Torxgewinde/Firebeetle-2-ESP32-E/(threads)

Thread 1 (2021-09-09):

VS Code Plattform.io IDE usage

progl0r, 2021-09-09:
Hey Torxgewinde,

thanks for the nicely done coding, very interesting application. My question is actually not related to the code itself. I guess you compiled and build the binaries with the Arduino IDE? Im working with VS code and platform.io but since I only find the Firebeetle (based on the ESP32, not E) board I wonder, if I could use the "old" board definition to flash your code. Do you have any information about that?

Best
Progl0r

Torxgewinde, 2021-09-10:
Hello ProgL0r,
Thank you. Yes, the *.ino files can be compiled with Arduino and PlatformIO. Also your guess is correct: I just used the predecessor Firebeetle ESP32 as board. Just a short while ago (=10 days as of now) the [Arduino ESP32 released a new version](https://github.com/espressif/arduino-esp32/releases/tag/2.0.0) and I did not check yet if the Firebeetle 2 ESP32-E is now included. Practically, the difference between previous Firebeetle ESP32 (SKU:DFR0478) and ESP32-E (SKU:DFR0654) did not matter, because I looked up the GPIO / Pin definitions from the DFRobot [schematic](https://dfimg.dfrobot.com/nobody/wiki/fd28d987619c16281bdc4f40990e5a1c.PDF) and [Wiki](https://wiki.dfrobot.com/FireBeetle_Board_ESP32_E_SKU_DFR0654) and did not use the Pin numbers like D\<number\>. The binaries the compiler is generating for ESP32 seem to run on ESP32-E unchanged. Obviously, I recommend to use the correct target once it is selectable to avoid obscure issues as it still might be a little bit different. If you are curious, the DFRobot specific changes are available [here](http://download.dfrobot.top/FireBeetle/). You can download the *.zip file and see that there is a file ```0.2.1/variants/esp32-e/pins_arduino.h``` that is just a pin mapping that can be avoided if you just use the GPIO numbers according to the pinout provided by DFRobot. The ```02.1./boards.txt``` contains the compile options for both variants, but without using things like PSRAM etc. it does also not cause practical issues just selecting the "old" ESP32 based Firebeetle.

TL;DR: For this project selecting the Firebeetle ESP32 works. If ESP32-E is available use that.

Thread 2 (2021-09-10):

Swap in Panasonic PaPIR

Torxgewinde, 2021-09-10:
1. HC-SR501 draws more current than the Panasonic PaPIRs. Swap in PaPIR and collect information about discharge rate, number of transmissions and wakeups.
2. Power PIR sensor through GPIO pin and switch the GPIO to LOW if battery is critically low and back to HIGH if battery is charged again.

Torxgewinde, 2021-11-23:
Done today, logging and patience will show by how much it improves

Closed 2021-11-23.

Thread 3 (2022-11-04):

Firebeetle (1) Version 4

Stefan774, 2022-11-04:
Hi I tried your code with my Firebeetle esp32 board but it does not work.
I noticed that you used the Firebeetle 2. Is it possible to add support vor Firebeetle (v1) as well? Or is HW missing?

Here is the board I'm using https://eckstein-shop.de/DFRobotFireBeetleESP32IOTMicrocontrollerSupportsWi-Fi26amp3BBluetoothEN

 Thanks in advance

Torxgewinde, 2022-11-04:
Hello Stefan,
The sketch in its current state is quite specific to the Firebeetle-2, but in general it should be doable to adjust it to also work with the predecessor. Certainly the GPIOs and internal peripheral names need to be checked and adjusted.

There is a schematic for Firebeetle v1 at https://raw.githubusercontent.com/DFRobot/Wiki/master/DFR0478/%5BDFR0478%5DFireBeetle%20Board-ESP32(V4.0)%E7%94%9F%E4%BA%A7%E6%A3%80%E6%9F%A5%E5%9B%BE.PDF

If you write "does not work", can you be more precise? Does it generate no output at all or can you paste the serial output after powering the Firebeetle v1 up? Can you please post the output of the serial console?

Torxgewinde, 2022-11-21:
Hey Stefan,
I am closing this for being stale. Please let me know if this is to be reopened.

Stefan774, 2022-11-21:
Hi Sorry had no time to reproduce the output and past it here. It showed an static value which seems not to represent the bat voltage. I think the v1 is missing the built in voltage defider. So add HW is needed? But dont know

Torxgewinde, 2022-11-21:
No worries, all good.
The v1 seems to have the voltage divider as well and it seems to be connected to A0. The schematic actually shows this:
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

If you find the time, can you please paste the output? Perhaps it gives some better insight.

tomkeuper, 2023-02-24:
I also have a Firebeetle ESP32 V4.0 and I wanted to get the battery voltage but using the readBattery function you sent here its giving me a voltage of 0.284000 but it fluctuates quite a bit to 0.754, 0.688 etc quite far from the exptected 3 Volts. I connected the battery through the Li-ion connector and all my script is doing atm is sending some sensor data over MQTT.

Could it be some calculation issue?

Closed 2022-12-24.

Thread 4 (2022-12-19):

REED switch input, reading out gas-meter (was: Connection of pir sensor)

VoyteckPL, 2022-12-19:
Which gpio pins are used to connect pir sensor? Is it possible to use reed sensor instead? I would lile to use this project for gas meter.

Torxgewinde, 2022-12-24:
Hi,
The comments point this out:
```
//PIR motion sensor is connected to GPIO4 (Pin: D12)
#define PIR_GPIO 4
#define PIR_DEEPSLEEP_PIN GPIO_NUM_4
```

In general reading a reed-switch should also be able to trigger the wakeup. Depending on the number of times it wakes the processor, just counting the events and transmitting a few times a day might be required to achieve good runtime. This certainly requires several changes, but is certainly achievable.

VoyteckPL, 2022-12-24:
Thanks. Is there any chance you could help me with the code? I can see you made a pro job here. I'm a total noob when it comes to arduino. I see there are some pir specific option like ignore after motion etc. I would be grateful if you could help.

Torxgewinde, 2022-12-24:
@VoyteckPL : Sure, I am willing to assist, however I am not coding it for you. I am also interested in measuring my gasmeter with a reed switch or the ESP32 internal hall sensor. If you have specific questions I suggest you post code and we can discuss and tweak it until it works. If the result is indeed powersaving enough, that is something I can only imagine but not promise yet. It SHOULD be OK in my opinion.

VoyteckPL, 2022-12-27:
Ok. When Firebeetle arrives I will do some testing. When I look at your code it seems to be good for reed switch with very little adjustments.

Torxgewinde, 2022-12-27:
That's cool. I also ordered a REED switch to test it and am looking forward to collaborate.

VoyteckPL, 2022-12-27:
Nice! My firebeetle should arrive tomorrow 🙂

VoyteckPL, 2022-12-28:
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

I'm trying to compile the code but I get this error. Which exactly libraries did you use?

#include <WiFi.h>
#include <MQTT.h>

#include "esp_adc_cal.h"

Torxgewinde, 2022-12-30:
I also need to check with the current Arduino-IDE.

The working versions are:
- Arduino IDE 1.8.13
- ESP32 Board Definitions Version 2.0.2

Maybe some path have changed and need to be updated. I will also use the current IDE and see what might have changed...

VoyteckPL, 2022-12-30:
Ok I will check and report back

Torxgewinde, 2022-12-30:
It also compiles, uploads and send serial output with:

- Arduino IDE 2.0.3
- ESP32 Boards Definition 2.0.6
- MQTT 2.5.0 (https://github.com/256dpi/arduino-mqtt) by Joël Gähwiler

It should compile and run. I haven't entered my WiFi-credentials yet and a full test.

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

VoyteckPL, 2022-12-30:
Fantastic. Thanks. I will do some testing today.

VoyteckPL, 2022-12-30:
Yay! I was able to compile. The problem was I didn't have 2.0.6 Board Definition installed. I had to manually add this link to preferences :

https://raw.githubusercontent.com/espressif/arduino-esp32/gh-pages/package_esp32_index.json

By default it was only 1.0.6.

VoyteckPL, 2022-12-30:
Ok so I sucessfully uploaded firmware! :) My reed sensor should be between pins GND and D12 (GPIO4) right? I won't be using that 3rd cable for 3.3V as I would for PIR sensor.

Torxgewinde, 2022-12-30:
Yes, if you use D12 you won't have to lookup to other `#define` , which saves you some lookups.

To provide current to the sensor, a Pullup or Pulldown resistor must be actived. The Arduino function `pinMode(PIR_GPIO, INPUT_PULLUP)` can be used. When enabling the internal pullup, you connect the reed-switch to D12 and GND.

VoyteckPL, 2022-12-30:
Thank you!
Unfortunately I have no idea how to adjust your code :( I tried but C++ is too hard for me at the moment as I'm newbie....
I can only help with logic and experience as I tested similar solution with Zigbee, Tasmota and ESPHome and I noticed the things which are really important for this gas meter. I can support you somehow if you take it in account. I would also do some testing and report back.

1. Debounce - I used around 1000 ms in Tasmota. This gave me perfect results without any false "clicks". This is a must. With this when gas meter stops just between on and off magnet it can cause multiple fake "clicks"
2. Internal counter in software - example situation > you do something in HA which needs restart but the gas consumption happends in background. In this case the gas consumption will continue but it won't be counted if the counter is in external software.
3. Adjust internal counter value wirelessly (maybe via MQTT) - sometimes you may want to adjust the counter to sync with real gas meter or for some other reason (testing). This should be doable wirelessly.
4. Report battery - already implemented
5. Wifi quality  signal in percent - really useful if gas meter is far away.
6. Ability to see if sensor is ON or OFF - just for information and for statistics.
7. Device should report always if sensor changes from ON to OFF or from OFF to ON.

I suppose that is all.
What I also noticed > I have only gas heater:
When water is heated (cycle which takes around 20 minutes) the usage is 0.01 m3 per ~15 seconds
When heating is on (it can take longer periods of time for example few hours of constant but slow gas consumption) the usage is 0.01 m3 per ~ 90 seconds.

I'm really sorry I can't help with the coding. I'm sure this solution will become very popular. I tested zigbee and it was not reliable (no signal quality info, loosing packets)

Torxgewinde, 2023-01-01:
Ok, no worries. Please chime back in anytime when you feel like picking up the project again and thank you for the hints, surely it helps when working on it again.

VoyteckPL, 2023-01-01:
No problem. If I could support you some other way - I'm open 😉 we can talk on WhatsApp if you wish.

Torxgewinde, 2023-01-07:
To read the Reed-switch and light the LED accordingly:
```
const int ReedPin = 4;
const int ledPin = 2;

void setup() {
  pinMode(ledPin, OUTPUT);
  pinMode(ReedPin, INPUT_PULLUP);
}

void loop() {
  digitalWrite(ledPin, digitalRead(ReedPin));
}
```

To read the reed-switch and debounce with a second:
```
/*******************************************************************************
#                                                                              #
# Using the Firebeetle 2 ESP32-E as battery powered gasmeter-reader            #
# Project: https://github.com/Torxgewinde/Firebeetle-2-ESP32-E                 #
#                                                                              #
# Firebeetle documentation at:                                                 #
# https://wiki.dfrobot.com/FireBeetle_Board_ESP32_E_SKU_DFR0654                #                                                             #
#                                                                              #
# Copyright (C) 2022 Tom Stöveken                                              #
#                                                                              #
# This program is free software; you can redistribute it and/or modify         #
# it under the terms of the GNU General Public License as published by         #
# the Free Software Foundation; version 2 of the License.                      #
#                                                                              #
# This program is distributed in the hope that it will be useful,              #
# but WITHOUT ANY WARRANTY; without even the implied warranty of               #
# MERCHANTABILITY or FITNESS FOR A PARTICULAR PURPOSE.  See the                #
# GNU General Public License for more details.                                 #
#                                                                              #
# You should have received a copy of the GNU General Public License            #
# along with this program; if not, write to the Free Software                  #
# Foundation, Inc., 59 Temple Place, Suite 330, Boston, MA  02111-1307  USA    #
#                                                                              #
********************************************************************************/

#include <WiFi.h>
#include <MQTT.h>

#include "esp_adc_cal.h"

#define ESSID "WIFI SSID"
#define PSK   "WIFI PASSWORD"

#define LOW_BATTERY_VOLTAGE 3.20
#define VERY_LOW_BATTERY_VOLTAGE 3.10
#define CRITICALLY_LOW_BATTERY_VOLTAGE 3.00

//char *MQTTServer = "server.lan";
IPAddress MQTTServer = IPAddress(192,168,1,1);
uint16_t MQTTPort = 1883;
String MQTTUsername = "username";
String MQTTPassword = "password";
String MQTTDeviceName = "Gaszaehler";
String MQTTRootTopic = "Keller/Gaszaehler";

enum _state {
  S_STARTUP = 0,
  S_DEBOUNCE_LOW,
  S_DEBOUNCE_HIGH,
  S_IDLE
};

enum _message {
  M_COUNTER = 0,
  M_STATUS
};

RTC_NOINIT_ATTR struct {
  uint8_t bssid[6];
  uint8_t channel;

  float BatteryVoltage;      //battery voltage in V
  uint64_t NumberOfRestarts; //number of restarts
  uint64_t ActiveTime;       //time being active in ms

  enum _state state;         //keep track of current state

  uint64_t counter;
} cache;

//REED contact is connected to GPIO4 (Pin: D12)
#define REED_GPIO 4
#define REED_DEEPSLEEP_PIN GPIO_NUM_4

#define DEBOUNCE_TIME 1*1000000ULL

//periodically wakeup and report battery status even without motion
#define LONG_TIME 12*60*60*1000000ULL

/******************************************************************************
Description.: bring the WiFi up
Input Value.: When "tryCachedValuesFirst" is true the function tries to use
              cached values before attempting a scan + association
Return Value: true if WiFi is up, false if it timed out
******************************************************************************/
bool WiFiUP(bool tryCachedValuesFirst) {
  WiFi.persistent(false);
  WiFi.mode(WIFI_STA);

  if(tryCachedValuesFirst && cache.channel > 0) {
    Serial.printf("Cached values as follows:\r\n");
    Serial.printf(" Channel....: %d\r\n", cache.channel);
    Serial.printf(" BSSID......: %x:%x:%x:%x:%x:%x\r\n", cache.bssid[0], \
                                                         cache.bssid[1], \
                                                         cache.bssid[2], \
                                                         cache.bssid[3], \
                                                         cache.bssid[4], \
                                                         cache.bssid[5]);

    WiFi.begin(ESSID, PSK, cache.channel, cache.bssid);

    for (unsigned long i=millis(); millis()-i < 10000;) {
      delay(10);

      if (WiFi.status() == WL_CONNECTED) {
        Serial.printf("WiFi connected with cached values (%lu)\r\n", millis()-i);
        return true;
      }
    }
  }

  cache.channel = 0;
  for (uint32_t i = 0; i < sizeof(cache.bssid); i++)
    cache.bssid[i] = 0;

  // try it with the slower process
  WiFi.begin(ESSID, PSK);

  for (unsigned long i=millis(); millis()-i < 60000;) {
    delay(10);

    if (WiFi.status() == WL_CONNECTED) {
      Serial.printf("WiFi connected (%lu)\r\n", millis()-i);

      uint8_t *bssid = WiFi.BSSID();
      for (uint32_t i = 0; i < sizeof(cache.bssid); i++)
        cache.bssid[i] = bssid[i];
      cache.channel = WiFi.channel();

      return true;
    }
  }

  Serial.printf("WiFi NOT connected\r\n");
  return false;
}

/******************************************************************************
Description.: reads the battery voltage through the voltage divider at GPIO34
              if the ESP32-E has calibration eFused those will be used.
              In comparison with a regular voltmeter the values of ESP32 and
              multimeter differ only about 0.05V
Input Value.: -
Return Value: battery voltage in volts
******************************************************************************/
float readBattery() {
  uint32_t value = 0;
  int rounds = 11;
  esp_adc_cal_characteristics_t adc_chars;

  //battery voltage divided by 2 can be measured at GPIO34, which equals ADC1_CHANNEL6
  adc1_config_width(ADC_WIDTH_BIT_12);
  adc1_config_channel_atten(ADC1_CHANNEL_6, ADC_ATTEN_DB_11);
  switch(esp_adc_cal_characterize(ADC_UNIT_1, ADC_ATTEN_DB_11, ADC_WIDTH_BIT_12, 1100, &adc_chars)) {
    case ESP_ADC_CAL_VAL_EFUSE_TP:
      Serial.println("Characterized using Two Point Value");
      break;
    case ESP_ADC_CAL_VAL_EFUSE_VREF:
      Serial.printf("Characterized using eFuse Vref (%d mV)\r\n", adc_chars.vref);
      break;
    default:
      Serial.printf("Characterized using Default Vref (%d mV)\r\n", 1100);
  }

  //to avoid noise, sample the pin several times and average the result
  for(int i=1; i<=rounds; i++) {
    value += adc1_get_raw(ADC1_CHANNEL_6);
  }
  value /= (uint32_t)rounds;

  //due to the voltage divider (1M+1M) values must be multiplied by 2
  //and convert mV to V
  return esp_adc_cal_raw_to_voltage(value, &adc_chars)*2.0/1000.0;
}

/******************************************************************************
Description.: send MQTT message
Input Value.: msg selects the message to send
Return Value: true if OK, false if errors occured
******************************************************************************/
bool SendMessage(enum _message msg) {
  char buf[256] = {0};

  //read RTC
  struct timeval tv;
  gettimeofday(&tv, NULL);

  //establish connection to MQTT server
  WiFiClient net;
  MQTTClient MQTTClient;
  MQTTClient.begin(MQTTServer, MQTTPort, net);
  MQTTClient.setOptions(30, true, 5000);

  if( MQTTClient.connect(MQTTDeviceName.c_str(), MQTTUsername.c_str(), MQTTPassword.c_str())) {
    switch(msg) {
      case M_COUNTER:
        Serial.printf("Sending counter: %d\r\n", cache.counter);

        MQTTClient.publish(MQTTRootTopic+"/counter", String(cache.counter), false, 2);
        break;
      case M_STATUS:
        Serial.printf("Sending status\r\n");

        MQTTClient.publish(MQTTRootTopic+"/counter", String(cache.counter), false, 2);
        MQTTClient.publish(MQTTRootTopic+"/BatteryVoltage", String(cache.BatteryVoltage, 3), false, 2);
        snprintf(buf, sizeof(buf)-1, "%ld.%06ld", tv.tv_sec, tv.tv_usec);
        MQTTClient.publish(MQTTRootTopic+"/BatteryRuntime", buf, false, 2);
        snprintf(buf, sizeof(buf)-1, "%llu", cache.NumberOfRestarts);
        MQTTClient.publish(MQTTRootTopic+"/Restarts", buf, false, 2);
        snprintf(buf, sizeof(buf)-1, "%llu", cache.ActiveTime);
        MQTTClient.publish(MQTTRootTopic+"/ActiveTime", buf, false, 2);
        snprintf(buf, sizeof(buf)-1, "%ld", WiFi.RSSI());
        MQTTClient.publish(MQTTRootTopic+"/RSSI", buf, false, 2);
        break;
      default:
        Serial.printf("unkown message, not sending anything\r\n");
    }
    MQTTClient.disconnect();
    return true;
  }

  return false;
}

/******************************************************************************
Description.: since this is a battery sensor, everything happens in setup
              and when the tonguing' is done the device enters deep-sleep
Input Value.: -
Return Value: -
******************************************************************************/
void setup() {
  //visual feedback when we are active, turn on onboard LED
  pinMode(2, OUTPUT);
  digitalWrite(2, HIGH);

  cache.NumberOfRestarts++;

  Serial.begin(115200);
  Serial.print("===================================================\r\n");
  Serial.printf("FireBeetle active\r\n" \
                " Compiled at: " __DATE__ " - " __TIME__ "\r\n" \
                " ESP-IDF: %s\r\n", esp_get_idf_version());

  //read battery voltage
  cache.BatteryVoltage = readBattery();
  Serial.printf("Voltage: %4.3f V\r\n", cache.BatteryVoltage);

  //a reset is required to wakeup again from below CRITICALLY_LOW_BATTERY_VOLTAGE
  //this is to prevent damaging the empty battery by saving as much power as possible
  if (cache.BatteryVoltage < CRITICALLY_LOW_BATTERY_VOLTAGE) {
    Serial.println("Battery critically low, hibernating...");

    //switch off everything that might consume power
    esp_sleep_pd_config(ESP_PD_DOMAIN_RTC_SLOW_MEM, ESP_PD_OPTION_OFF);
    esp_sleep_pd_config(ESP_PD_DOMAIN_RTC_FAST_MEM, ESP_PD_OPTION_OFF);
    esp_sleep_pd_config(ESP_PD_DOMAIN_RTC_PERIPH, ESP_PD_OPTION_OFF);
    esp_sleep_pd_config(ESP_PD_DOMAIN_XTAL, ESP_PD_OPTION_OFF);
    esp_sleep_pd_config(ESP_PD_DOMAIN_VDDSDIO, ESP_PD_OPTION_OFF);
    //esp_sleep_pd_config(ESP_PD_DOMAIN_CPU, ESP_PD_OPTION_OFF);

    //disable all wakeup sources
    esp_sleep_disable_wakeup_source(ESP_SLEEP_WAKEUP_ALL);

    cache.ActiveTime += millis();
    digitalWrite(2, LOW);
    esp_deep_sleep_start();

    Serial.println("This should never get printed");
    return;
  }

  //if battery is below LOW_BATTERY_VOLTAGE but still above CRITICALLY_LOW_BATTERY_VOLTAGE,
  //stop doing the regular work
  //when put on charge the device will wakeup after a while and recognize voltage is OK
  //this way the battery can run low, put still wakeup without physical interaction
  if (cache.BatteryVoltage < LOW_BATTERY_VOLTAGE) {
    Serial.println("Battery low, deep sleeping...");

    //sleep ~60 minutes if battery is CRITICALLY_LOW_BATTERY_VOLTAGE to VERY_LOW_BATTERY_VOLTAGE
    //sleep ~10 minutes if battery is VERY_LOW_BATTERY_VOLTAGE to LOW_BATTERY_VOLTAGE
    uint64_t sleeptime = (cache.BatteryVoltage >= VERY_LOW_BATTERY_VOLTAGE) ? \
                           10*60*1000000ULL : 60*60*1000000ULL;

    esp_sleep_enable_timer_wakeup(sleeptime);
    cache.ActiveTime += millis();
    digitalWrite(2, LOW);
    esp_deep_sleep_start();

    Serial.println("This should never get printed");
    return;
  }

  //read GPIO level
  pinMode(REED_GPIO, INPUT_PULLUP);
  int level = digitalRead(REED_GPIO);
  Serial.printf("Reed-switch is: %s\r\n", (level)?"NOMAGNET":"MAGNET");

  //check if a reset/power-on occured
  if (esp_reset_reason() == ESP_RST_POWERON) {
      Serial.printf("ESP was just switched ON\r\n");
      cache.state = S_STARTUP;
      cache.ActiveTime = 0;
      cache.NumberOfRestarts = 0;
      cache.counter = 0;

      //set RTC to 0
      struct timeval tv;
      tv.tv_sec = 0;
      tv.tv_usec = 0;
      settimeofday(&tv, NULL);

      //default is to have WiFi off
      if (WiFi.getMode() != WIFI_OFF) {
        Serial.printf("WiFi wasn't off!\r\n");
        WiFi.persistent(true);
        WiFi.mode(WIFI_OFF);
      }

      //try to connect
      WiFiUP(false);
      WiFi.disconnect(true, true);

      //transition to new state
      cache.state = (level == HIGH) ? S_DEBOUNCE_HIGH : S_DEBOUNCE_LOW;
      Serial.printf("transition to state nr.: %d\r\n", cache.state);
      //wake by timer after debounce time is up
      esp_sleep_enable_timer_wakeup(DEBOUNCE_TIME);
  }

  // check if ESP returns from deepsleep
  if (esp_reset_reason() == ESP_RST_DEEPSLEEP) {
    switch(esp_sleep_get_wakeup_cause()) {
      case ESP_SLEEP_WAKEUP_TIMER:
        Serial.printf("ESP woke up due to timer\r\n");

        switch(cache.state) {
          case S_DEBOUNCE_LOW:
          case S_DEBOUNCE_HIGH:
            if(level == LOW && cache.state == S_DEBOUNCE_LOW) {
              cache.counter++;
              WiFiUP(true);
              SendMessage(M_COUNTER);
              WiFi.disconnect(true, true);
            }

            Serial.printf("transition to state S_IDLE\r\n");
            cache.state = S_IDLE;
            esp_sleep_enable_timer_wakeup(LONG_TIME);
            esp_sleep_enable_ext0_wakeup(REED_DEEPSLEEP_PIN, (level == LOW)?1:0);
            break;

          case S_IDLE:
            WiFiUP(true);
            SendMessage(M_STATUS);
            WiFi.disconnect(true, true);

            Serial.printf("remaining in state S_IDLE\r\n");
            cache.state = S_IDLE;
            esp_sleep_enable_timer_wakeup(LONG_TIME);
            esp_sleep_enable_ext0_wakeup(REED_DEEPSLEEP_PIN, (level == LOW)?1:0);
            break;

          default:
            Serial.printf("ESP woke up by timer in an unknown state\r\n");
        }
        break;

      case ESP_SLEEP_WAKEUP_EXT0:
        Serial.printf("ESP woke up by EXT0\r\n");

        if (level == HIGH) {
          cache.state = S_DEBOUNCE_HIGH;
          Serial.printf("transition to state S_DEBOUNCE_HIGH\r\n");
        }
        else {
          cache.state = S_DEBOUNCE_LOW;
          Serial.printf("transition to state S_DEBOUNCE_LOW\r\n");
        }

        esp_sleep_enable_timer_wakeup(DEBOUNCE_TIME);
        break;

      default:
        Serial.printf("ESP woke up due to an unknown reason\r\n");
    }
  }

  Serial.printf("counter: %llu\r\n", cache.counter);
  Serial.printf("=== entering deepsleep after %d ms ===\r\n.\r\n.\r\n.\r\n", millis());
  cache.ActiveTime += millis();
  digitalWrite(2, LOW);
  esp_deep_sleep_start();

  Serial.println("This should never get printed");
}

void loop() {
  Serial.println("This should never get printed");
}
```

It is not done yet, but this is what I currently have.
Providing the gasmeter start-value is still missing...

VoyteckPL, 2023-01-07:
Wow, you made it! Fantastic work! I don't want to push you to much but internal counter would be a complete gas meter. Any way to buy you a coffee? 🙂

VoyteckPL, 2023-01-07:
Amazing work! Let me know if I can buy you a coffee somehow!

VoyteckPL, 2023-01-07:
One question : in this example if gas meter stops or OPEN or CLOSED position will it always go to deep sleep?

Torxgewinde, 2023-01-07:
The idea is, that it wakes up by changes to the reed-state. Only if the magnet is present (trigger) and still present after a second (for debounce) it increments the counter and transmits the counter via MQTT. To conserve battery it sleeps most of the time.

What is missing to wakeup every N-counts or every N-hours to transmit the whole status and the offset to start counting from.  It is work in progress and not done yet!

VoyteckPL, 2023-01-07:
This is very promising! Just uploaded and tested and speed is amazing. Around 2 seconds maximum for connection and send mqtt! The only problem I noticed so far is reset of counter after lost power and I only see counter in MQTT (no other values like voltage etc.)
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

VoyteckPL, 2023-01-07:
Just one more clue ;) Usually one revolution of gas meter is 0.01 m3. It would be nice to have it with the decimals as result in MQTT rather than converting in from 1 to 0.01 in frontend.

Torxgewinde, 2023-01-07:
Yes, i changed "counter" to be a "retained" value now. That way the broker will store the value even when resetting the ESP32 or changing the battery.

The new behavior will be:
- Start ESP32 (first time or after reset pressed) --> obtain the counter from MQTT-Broker.
- Either the value of "counter" is still valid from last time, or the user set it manually by `mosquitto_pub -t "Keller/Gaszaehler/counter" -h server.lan -u "username" -P "password" -m "12345" -r`. Regardless who put the last value, the value as in the MQTT-broker will be incremented. from then on. The ESP32 will only check for this value after a reset or when power-cycling it.

Conversion of counts to actual qubic-meters m³ might follow. I am happy if battery runtime can be checked and is acceptable - that is my main concern for now.

```
/*******************************************************************************
#                                                                              #
# Using the Firebeetle 2 ESP32-E as battery powered gasmeter-reader            #
# Project: https://github.com/Torxgewinde/Firebeetle-2-ESP32-E                 #
#                                                                              #
# Firebeetle documentation at:                                                 #
# https://wiki.dfrobot.com/FireBeetle_Board_ESP32_E_SKU_DFR0654                #                                                             #
#                                                                              #
# Copyright (C) 2022 Tom Stöveken                                              #
#                                                                              #
# This program is free software; you can redistribute it and/or modify         #
# it under the terms of the GNU General Public License as published by         #
# the Free Software Foundation; version 2 of the License.                      #
#                                                                              #
# This program is distributed in the hope that it will be useful,              #
# but WITHOUT ANY WARRANTY; without even the implied warranty of               #
# MERCHANTABILITY or FITNESS FOR A PARTICULAR PURPOSE.  See the                #
# GNU General Public License for more details.                                 #
#                                                                              #
# You should have received a copy of the GNU General Public License            #
# along with this program; if not, write to the Free Software                  #
# Foundation, Inc., 59 Temple Place, Suite 330, Boston, MA  02111-1307  USA    #
#                                                                              #
********************************************************************************/

#include <WiFi.h>
#include <MQTT.h>
#include <stdlib.h>

#include "esp_adc_cal.h"

#define ESSID ""
#define PSK   ""

#define LOW_BATTERY_VOLTAGE 3.20
#define VERY_LOW_BATTERY_VOLTAGE 3.10
#define CRITICALLY_LOW_BATTERY_VOLTAGE 3.00

//char *MQTTServer = "server.lan";
IPAddress MQTTServer = IPAddress(192,168,1,1);
uint16_t MQTTPort = 1883;
String MQTTUsername = "";
String MQTTPassword = "";
String MQTTDeviceName = "Gaszaehler";
String MQTTRootTopic = "Keller/Gaszaehler";

enum _state {
  S_STARTUP = 0,
  S_DEBOUNCE_LOW,
  S_DEBOUNCE_HIGH,
  S_IDLE
};

enum _message {
  M_COUNTER = 0,
  M_STATUS
};

RTC_NOINIT_ATTR struct {
  uint8_t bssid[6];
  uint8_t channel;

  float BatteryVoltage;      //battery voltage in V
  uint64_t NumberOfRestarts; //number of restarts
  uint64_t ActiveTime;       //time being active in ms

  enum _state state;         //keep track of current state

  uint64_t counter;          //gasmeter-counter
} cache;

//REED contact is connected to GPIO4 (Pin: D12)
#define REED_GPIO 4
#define REED_DEEPSLEEP_PIN GPIO_NUM_4

#define DEBOUNCE_TIME 1*1000000ULL

//periodically wakeup and report battery status
#define LONG_TIME 6*60*60*1000000ULL

/******************************************************************************
Description.: bring the WiFi up
Input Value.: When "tryCachedValuesFirst" is true the function tries to use
              cached values before attempting a scan + association
Return Value: true if WiFi is up, false if it timed out
******************************************************************************/
bool WiFiUP(bool tryCachedValuesFirst) {
  WiFi.persistent(false);
  WiFi.mode(WIFI_STA);

  if(tryCachedValuesFirst && cache.channel > 0) {
    Serial.printf("Cached values as follows:\r\n");
    Serial.printf(" Channel....: %d\r\n", cache.channel);
    Serial.printf(" BSSID......: %x:%x:%x:%x:%x:%x\r\n", cache.bssid[0], \
                                                         cache.bssid[1], \
                                                         cache.bssid[2], \
                                                         cache.bssid[3], \
                                                         cache.bssid[4], \
                                                         cache.bssid[5]);

    WiFi.begin(ESSID, PSK, cache.channel, cache.bssid);

    for (unsigned long i=millis(); millis()-i < 10000;) {
      delay(10);

      if (WiFi.status() == WL_CONNECTED) {
        Serial.printf("WiFi connected with cached values (%lu)\r\n", millis()-i);
        return true;
      }
    }
  }

  cache.channel = 0;
  for (uint32_t i = 0; i < sizeof(cache.bssid); i++)
    cache.bssid[i] = 0;

  // try it with the slower process
  WiFi.begin(ESSID, PSK);

  for (unsigned long i=millis(); millis()-i < 60000;) {
    delay(10);

    if (WiFi.status() == WL_CONNECTED) {
      Serial.printf("WiFi connected (%lu)\r\n", millis()-i);

      uint8_t *bssid = WiFi.BSSID();
      for (uint32_t i = 0; i < sizeof(cache.bssid); i++)
        cache.bssid[i] = bssid[i];
      cache.channel = WiFi.channel();

      return true;
    }
  }

  Serial.printf("WiFi NOT connected\r\n");
  return false;
}

/******************************************************************************
Description.: reads the battery voltage through the voltage divider at GPIO34
              if the ESP32-E has calibration eFused those will be used.
              In comparison with a regular voltmeter the values of ESP32 and
              multimeter differ only about 0.05V
Input Value.: -
Return Value: battery voltage in volts
******************************************************************************/
float readBattery() {
  uint32_t value = 0;
  int rounds = 11;
  esp_adc_cal_characteristics_t adc_chars;

  //battery voltage divided by 2 can be measured at GPIO34, which equals ADC1_CHANNEL6

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

Thread 5 (2023-01-15):

DFR0654 & plaform.io

imabot2, 2023-01-15:
Hi, I'm not sure which board and MCU I have to select to program a [DRF0654 board](https://wiki.dfrobot.com/FireBeetle_Board_ESP32_E_SKU_DFR0654).

I try several configurations, `firebeetle32`, `dfrobot_firebeetle2_esp32s3` with different MCU configuration (`esp32`, `ESP32-E`), but none of then is working properly.

With the following configuration, I can upload the code, but pinout seems to be wrong. I think this is not the right configuration:

```
board = dfrobot_firebeetle2_esp32s3
board_build.mcu = esp32
```

Any help is welcome.

Torxgewinde, 2023-01-16:
Hello Fifi,
I cannot say for sure which PlatformIO settings are correct, because I am using the Arduino-IDE.

The settings in Arduino-IDE are as per this screenshot:
[As in issue #4](https://user-images.githubusercontent.com/12876583/210063434-cd9c5403-7cae-406d-a20f-511611c7f7f6.png)

I would expect PlatformIO to also use ESP32-E as mcu, their [current repository](https://github.com/platformio/platform-espressif32/tree/master/boards) does not seem to include this board (DFR0654, ESP32-E) yet. [I would suggest watching your issue #1002 in the Platformio project](https://github.com/platformio/platform-espressif32/issues/1002), because the issue needs to be fixed there.

Best regards!

Closed 2023-01-19.

Thread 6 (2025-06-12):

Deco Mesh connection

VoyteckPL, 2025-06-12:
Hi!
I recently changed my home routers to Deco. I set up IoT wifi only for IoT devices. I have one AP very close to gas meter. Sometimes it connects to it and shows wifi strength around 60-70% but sometimes randomly it is connecting to a different AP in same network and shows around 10% of wifi strength. I don't see it in my Deco app because it is connecting for such short time due to deep sleep and I can't even set IP in DHCP table and set it to connect particular AP which is possible to be set for devices online. Is there any solution for this?
