Torxgewinde/Firebeetle-2-ESP32-E/(commit log)

2021-08-22 Protect battery by sleeping and hibernating
    remove TLS, it just takes too long for battery powered node and caching/ticketing/serializing the SSL context does not work. Plain text MQTT and WPA2-PSK together takes about 600 ms on average loop, which is acceptable.
2021-08-24 Query PIR sensors at GPIO4 and wakeup on change
    Attached a PIR sensor to GPIO4 and programmed that the ESP wakes up if the level changes from on to off or from off to on.
2021-08-26 Report PIR changes occuring while connecting
    If establishing WiFi connections takes very long and the PIR motion sensor changes state report the previous and current state via MQTT
2021-08-26 Add pictures of development board
2021-11-23 Changes for Panasonic PaPIR EKMB1303111K
    These PIR sensors consume only 6 µA. After transmitting the sensor has to settle before detecting motion again, or it will self trigger. A state machine is used to keep track of the timings. Added a couple of statistics to the MQTT messages. Tested with ESP32 toolchain 2.0.1
2022-03-01 Added real life measurements
    Battery is still going strong after a couple of months now, added plot
2022-05-23 updated recent voltage levels and recent picture
    The battery is still quite full
2023-01-21 Reading a Gasmeter like BK-G4 or similar with a reed-switch
    Reading a gasmeter with a battery powered Firebeetle and transmitting the counter to an MQTT server viw WiFi
